cobanov/mini-pc-case/docs/preview.png

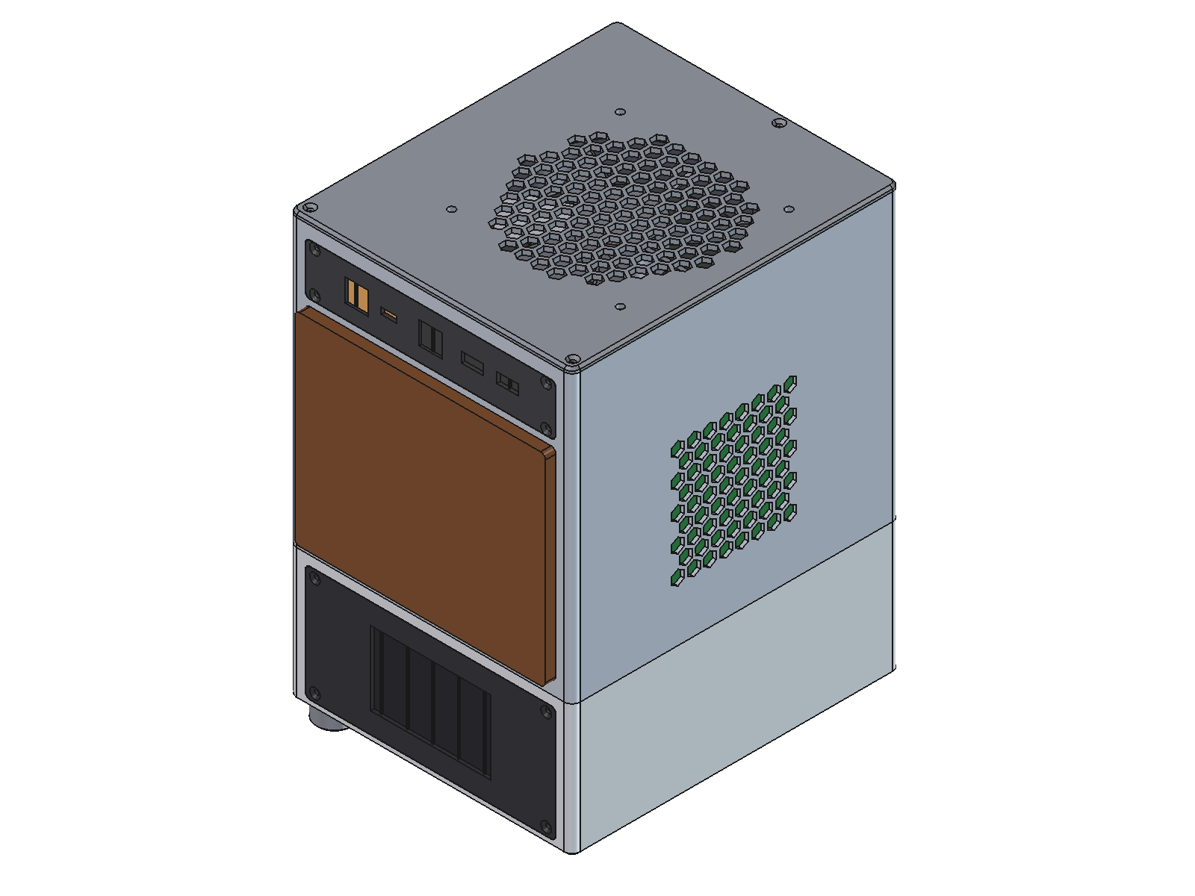
docs/preview.png
