cobanov/mini-pc-case/mini-pc-case.FCStd

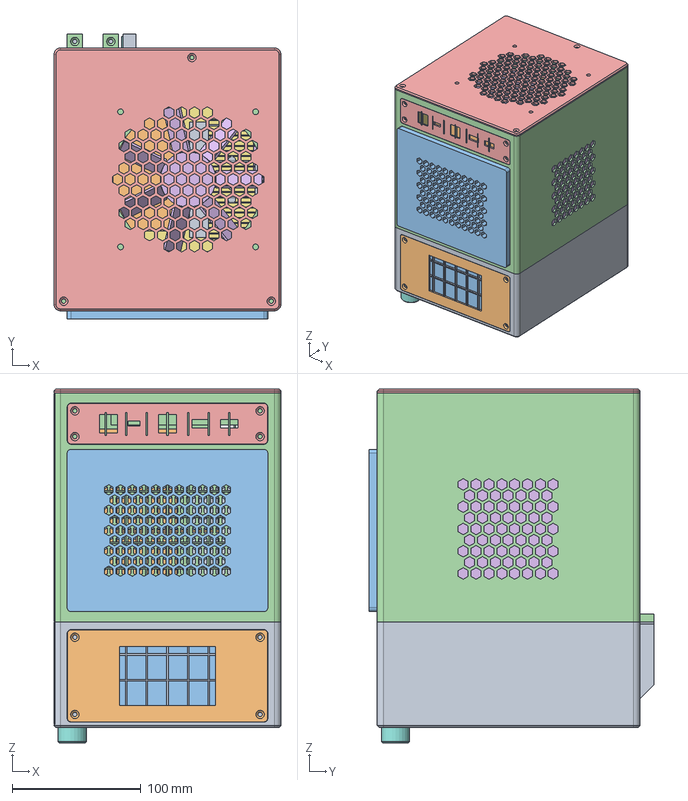
[picture p6: CAD file, 2026-10-29]
mini-pc-case.FCStd
176.4 x 221.9 x 275.2 mm
body_lower
body_upper
body_upper_mesh
body_upper_panel
lid
side_lower
side_upper
foot
psu_support
front_lower
faceplate
front_upper
strip
ref_board
ref_gpu
ref_bracket
ref_cooler
ref_psu
ref_ssd
ref_fan_top
ref_fan_bottom
rotor_top
rotor_bottom
rotor_cpu
rotor_gpu
rotor_psu
ref_lcd
