cobanov/mini-pc-case/stl/body_upper_panel.step

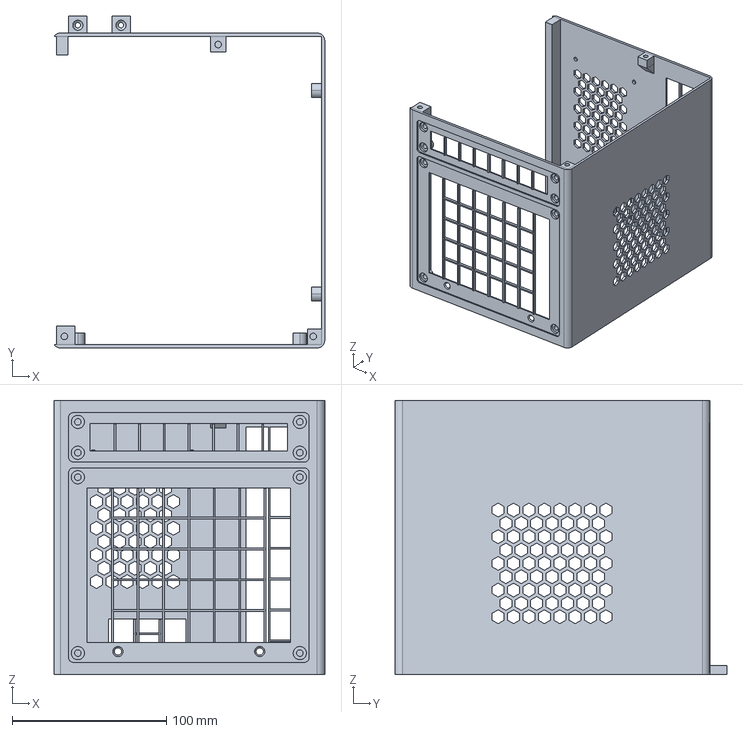
[picture p7: CAD file, 2026-10-29]
stl/body_upper_panel.step
175.5 x 215.4 x 178.0 mm
