cobanov/mini-pc-case/stl/body_upper.step

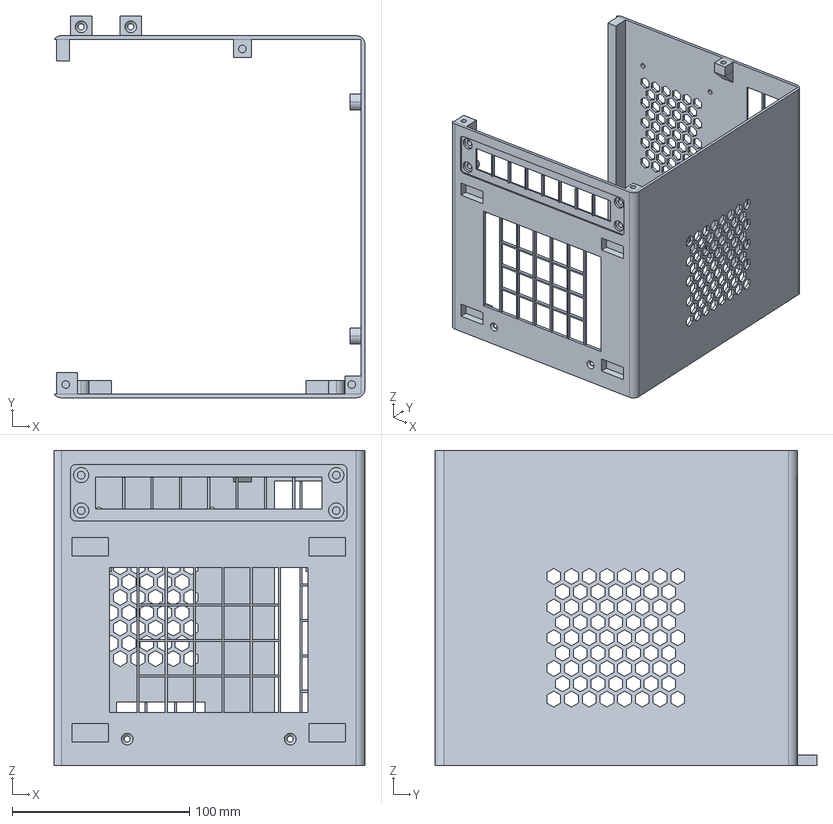
[picture p8: CAD file, 2026-10-29]
stl/body_upper.step
175.5 x 215.4 x 178.0 mm
