cobanov/mini-pc-case/stl/body_lower.step

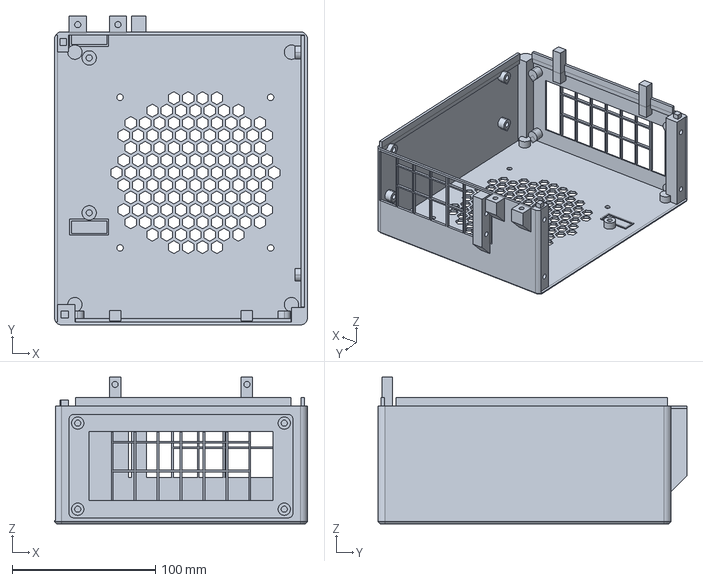
[picture p9: CAD file, 2026-10-29]
stl/body_lower.step
176.4 x 215.4 x 102.2 mm
