cobanov/mini-pc-case/stl/test_piece.step

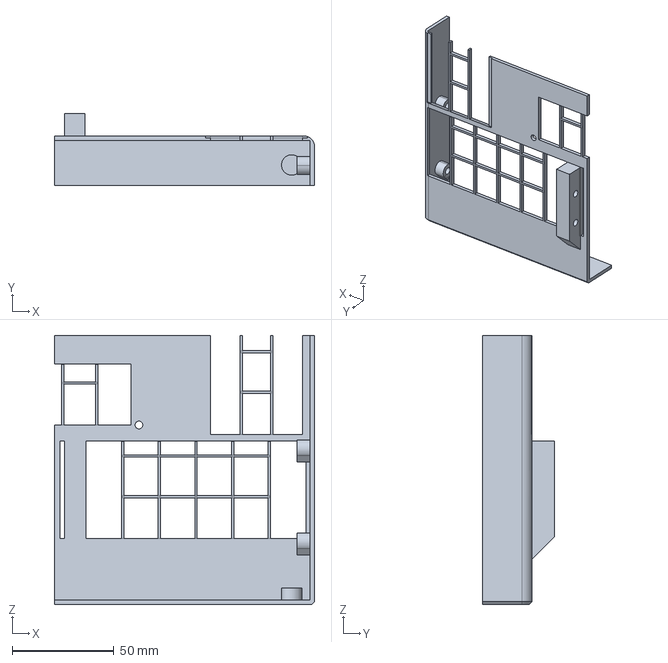
[picture p10: CAD file, 2026-10-28]
stl/test_piece.step
127.6 x 35.2 x 132.2 mm
