cobanov/mini-pc-case/stl/front_upper.step

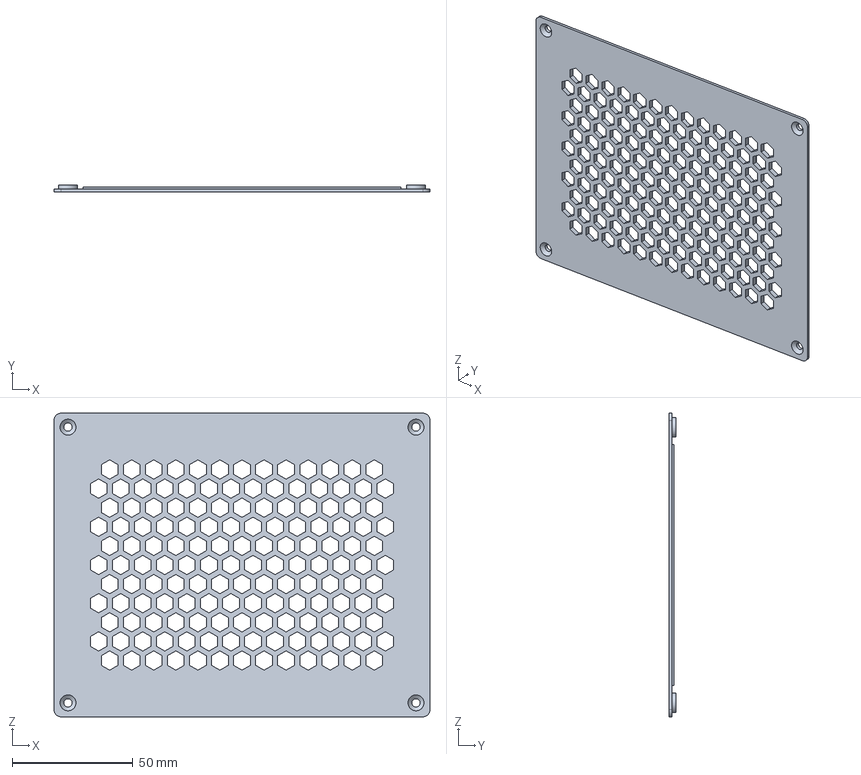
[picture p11: CAD file, 2026-10-24]
stl/front_upper.step
155.6 x 3.04 x 125.7 mm
