cobanov/mini-pc-case/stl/front_upper_fan.step

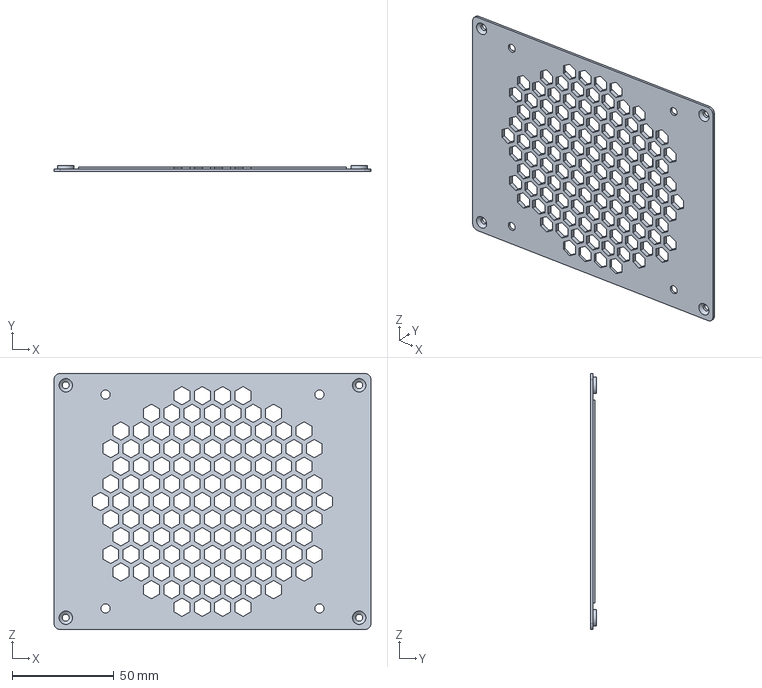
[picture p12: CAD file, 2026-10-24]
stl/front_upper_fan.step
155.6 x 3.04 x 125.7 mm
