cobanov/mini-pc-case/stl/strip_plain.step

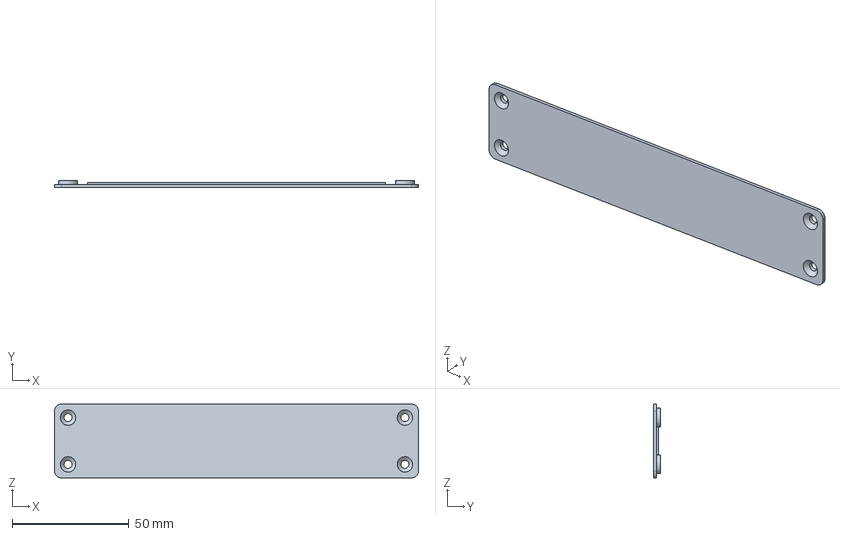
[picture p14: CAD file, 2026-10-24]
stl/strip_plain.step
155.6 x 3.04 x 31.6 mm
