cobanov/mini-pc-case/stl/side_upper.step

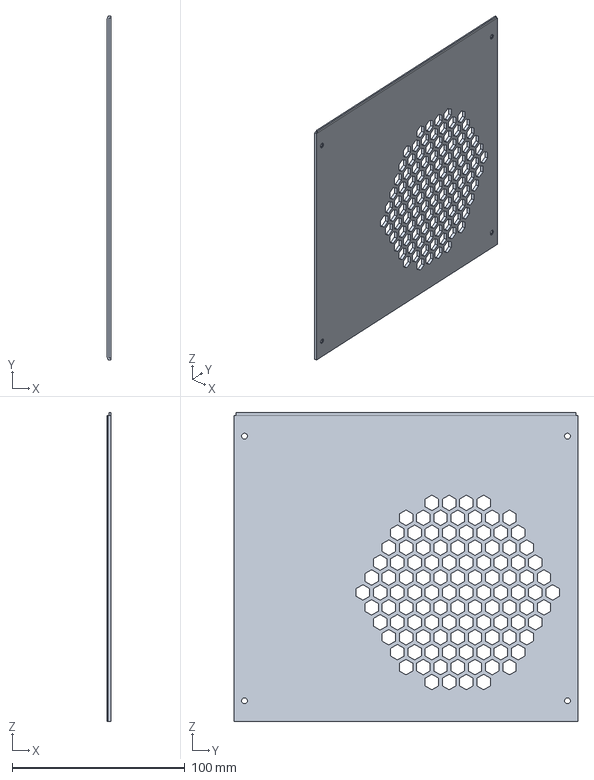
[picture p15: CAD file, 2026-10-24]
stl/side_upper.step
2.20 x 199.2 x 179.1 mm
