cobanov/mini-pc-case/stl/lid.step

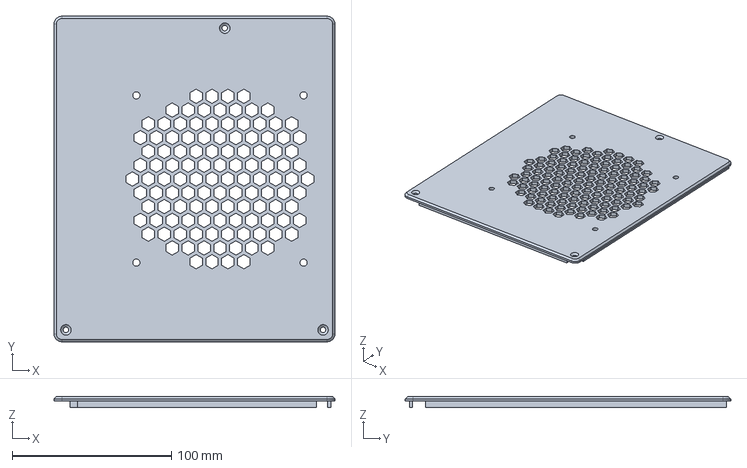
[picture p16: CAD file, 2026-10-24]
stl/lid.step
176.4 x 204.4 x 7.00 mm
