cobanov/mini-pc-case/stl/front_lower_plain.step

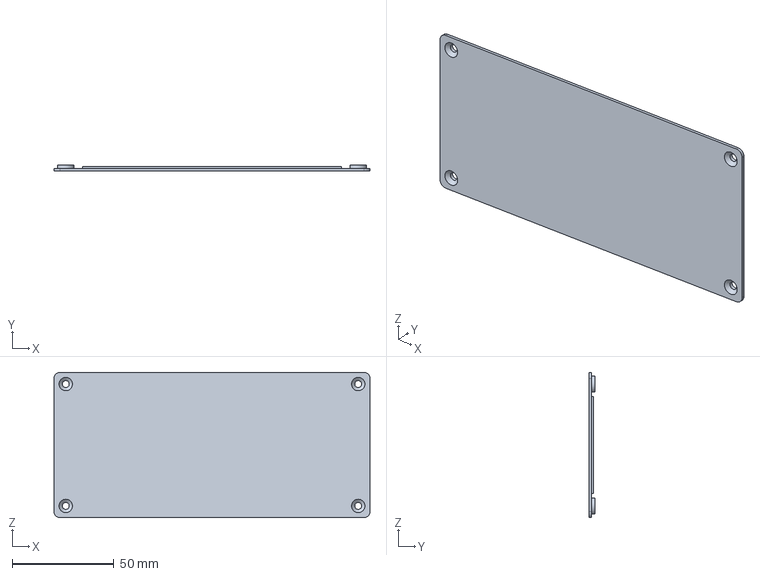
[picture p17: CAD file, 2026-10-24]
stl/front_lower_plain.step
155.6 x 3.04 x 71.6 mm
