cobanov/mini-pc-case/stl/side_lower.step

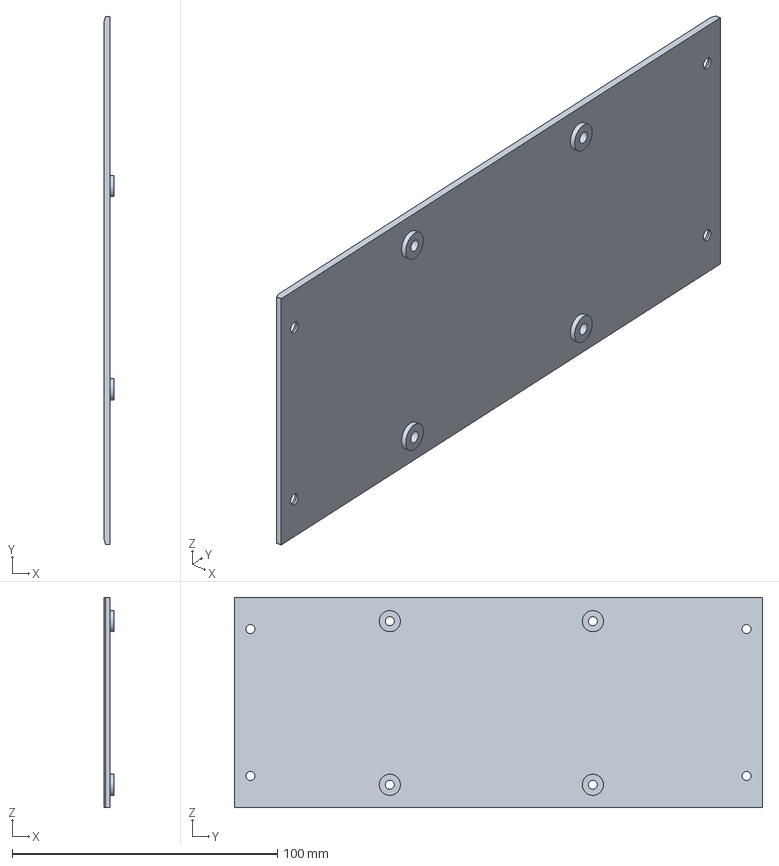
[picture p18: CAD file, 2026-10-24]
stl/side_lower.step
3.70 x 199.2 x 79.4 mm
