cobanov/mini-pc-case/stl/faceplate.step

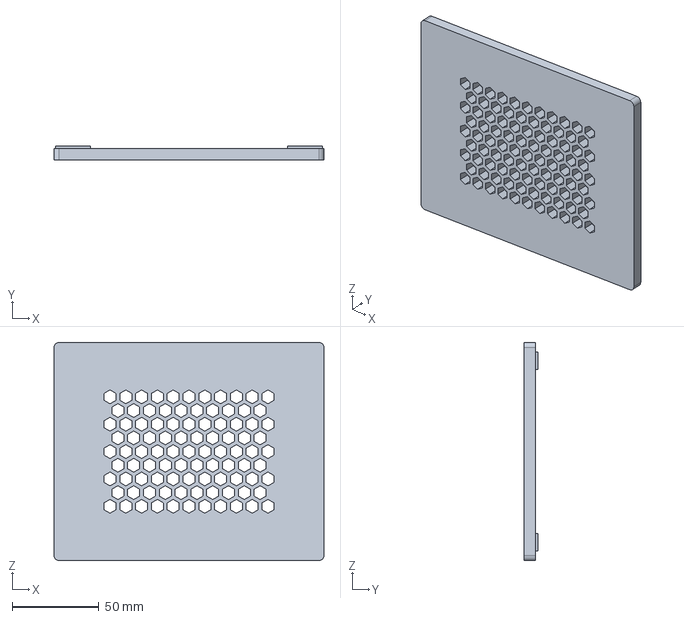
[picture p19: CAD file, 2026-10-24]
stl/faceplate.step
156.0 x 8.00 x 126.1 mm
