cobanov/mini-pc-case/stl/psu_support.step

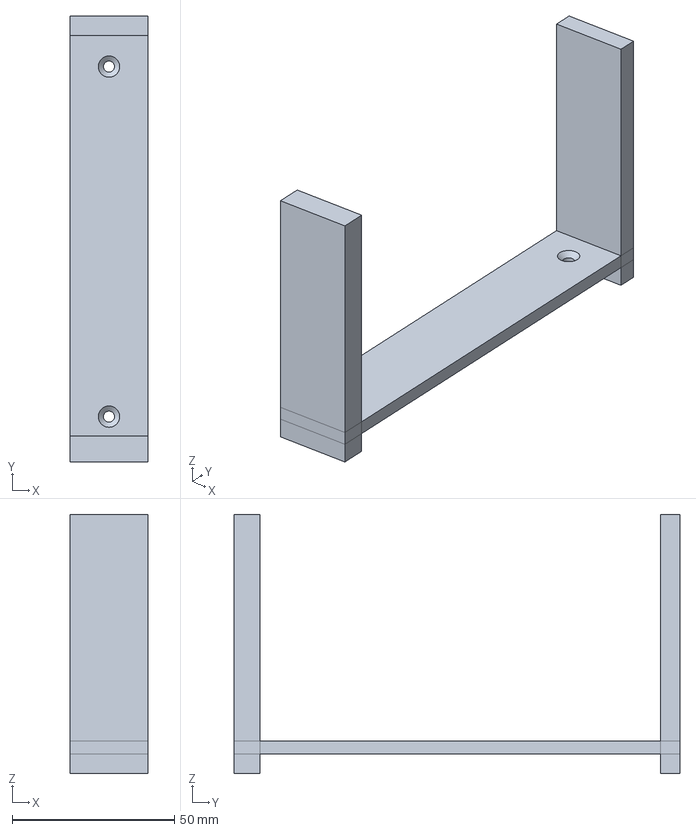
[picture p20: CAD file, 2026-10-24]
stl/psu_support.step
24.0 x 137.6 x 80.0 mm
