cobanov/mini-pc-case/stl/faceplate_plain.step

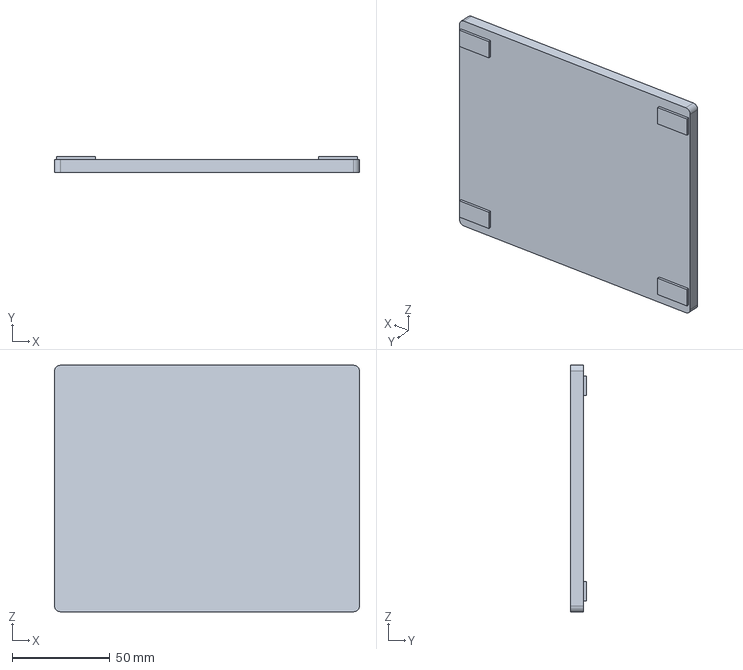
[picture p21: CAD file, 2026-10-24]
stl/faceplate_plain.step
156.0 x 8.00 x 126.1 mm
