cobanov/mini-pc-case/stl/front_upper_screen.step

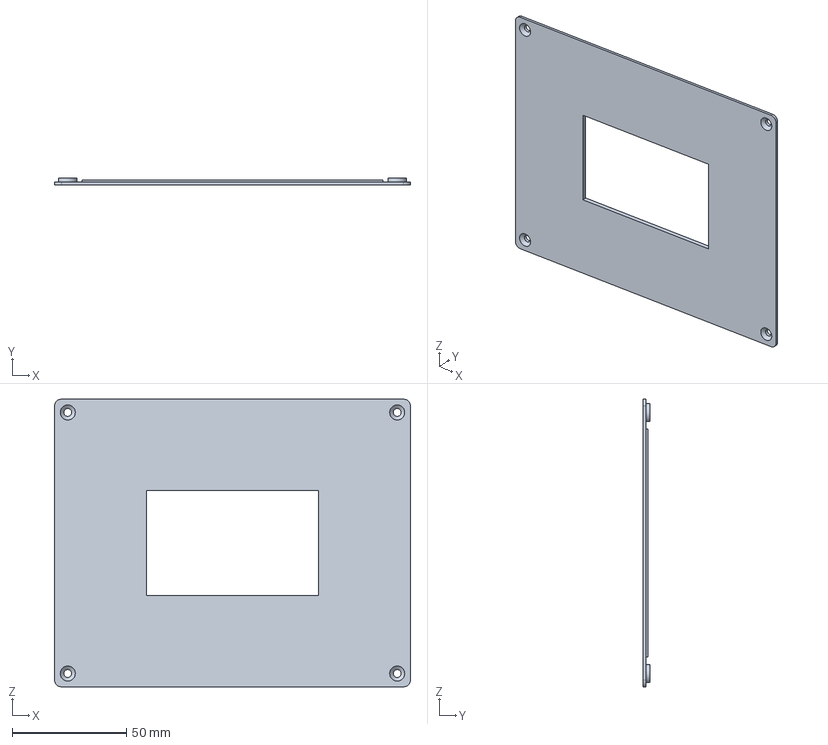
[picture p23: CAD file, 2026-10-24]
stl/front_upper_screen.step
155.6 x 3.04 x 125.7 mm
