cobanov/mini-pc-case/stl/foot.step

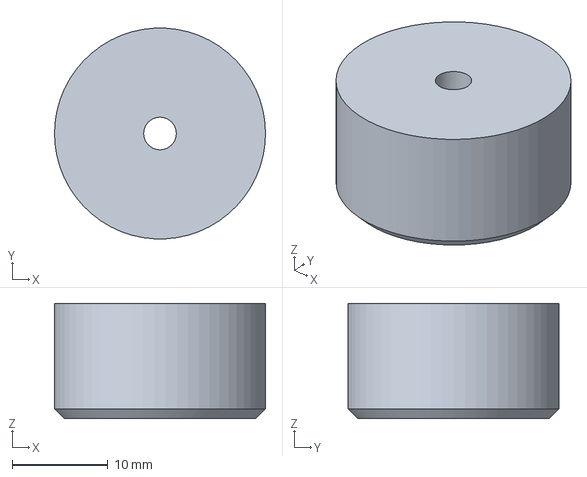
[picture p24: CAD file, 2026-10-24]
stl/foot.step
22.0 x 22.0 x 12.0 mm
