cobanov/mini-pc-case/stl/strip.step

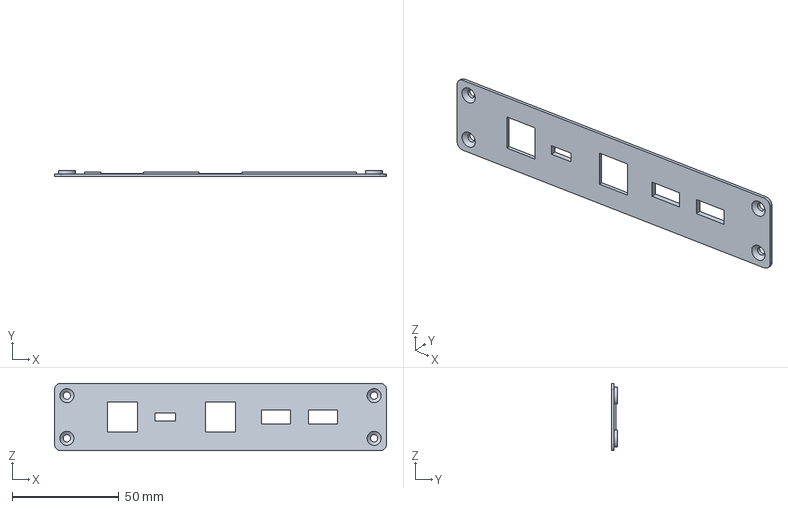
[picture p26: CAD file, 2026-10-24]
stl/strip.step
155.6 x 3.04 x 31.6 mm
