cobanov/mini-pc-case/stl/front_upper_plain.step

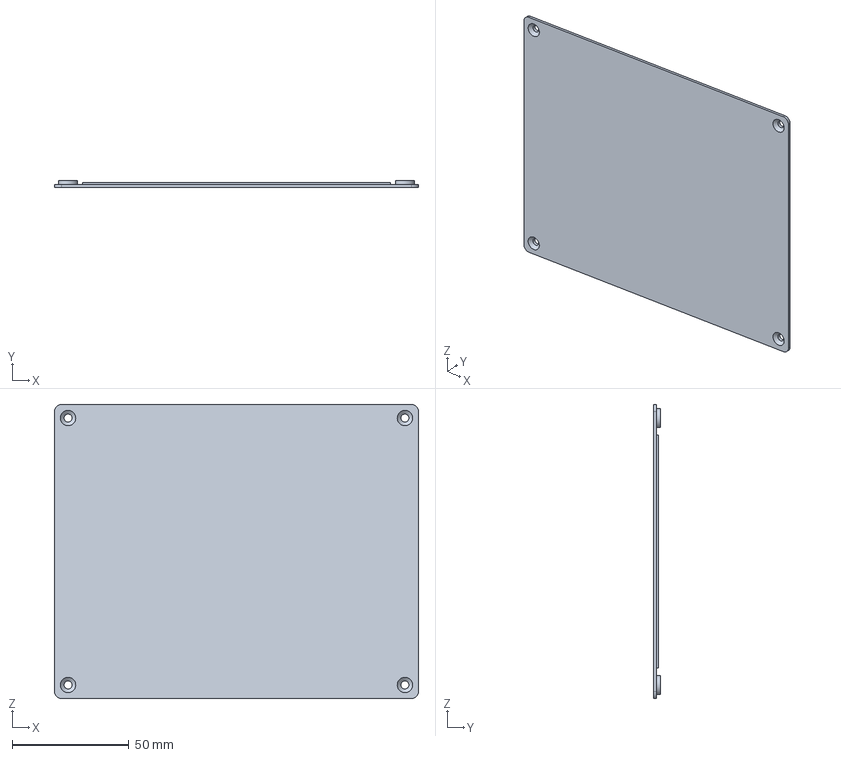
[picture p28: CAD file, 2026-10-24]
stl/front_upper_plain.step
155.6 x 3.04 x 125.7 mm
