cobanov/mini-pc-case/(list of files, cad)

Other CAD files:
stl/body_upper_mesh.step
stl/body_lower.stl
stl/body_upper.stl
stl/body_upper_mesh.stl
stl/body_upper_panel.stl
stl/faceplate.stl
stl/faceplate_plain.stl
stl/faceplate_screen.stl
stl/foot.stl
stl/front_lower.stl
stl/front_lower_mesh.stl
stl/front_lower_plain.stl
stl/front_upper.stl
stl/front_upper_fan.stl
stl/front_upper_plain.stl
stl/front_upper_screen.stl
stl/lid.stl
stl/psu_support.stl
stl/side_lower.stl
stl/side_upper.stl
stl/strip.stl
stl/strip_plain.stl
stl/strip_switches.stl
stl/test_piece.stl
