cobanov/mini-pc-case/(commit log)

2026-10-23 Mini PC case v4: split body, Steam Machine compatible front plate, swappable panels, web viewer
    Claude-Session: https://claude.ai/code/session_01DaiooKNgwSLmkrL9h7BFFJ
    [ayak.step, ayak.stl, deneme_parcasi.step, deneme_parcasi.stl, govde_alt.step, govde_alt.stl, govde_ust.step, govde_ust.stl]
2026-10-23 Add viewer deploy config, preview image
    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
    [mini-pc-kasa.FCStd]
2026-10-24 English names throughout, screw placement standard, removable PSU support, symmetric grilles, size references
    - Removable-part screws: 6 mm from every visible edge (panels, covers, lid, tabs); fastener audit now probes the edge margin around each head
    - Rear joint tabs 12 x 12 at x 14 and 42 (off the GPU opening), lid rear boss and rear post widened
    - PSU support is its own screwed part with a footprint outline on the floor
    - Hex grilles centred and mirror-symmetric
    - Part names, docs (ASSEMBLY.md, NOTES.md, README) and viewer UI in English; parts listed top to bottom
    - Viewer: Steam Machine (Valve CAD) and iPhone 18 Pro Max toggles for scale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
    [ayak.step, body_lower.step, body_lower.stl, body_upper.step, body_upper.stl, deneme_parcasi.step, deneme_parcasi.stl, faceplate.step]
2026-10-24 Faceplate defaults to the mesh variant
    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
    [faceplate_mesh.step, faceplate_mesh.stl, mini-pc-case.FCStd]
2026-10-24 Three upper fronts, 20x10x2 bar magnets, switches-only strip, color groups and palettes
    - body_upper (Steam plate mount), body_upper_mesh (hex mesh, no plate), body_upper_panel (screwed 156x126 panel frame) + front_upper panel variants
    - Magnets: common 20x10x2 mm neodymium bars; plate carries printed bosses, case pocket holds the second bar; front joint screws moved to x 40/132
    - strip_switches: power and reset only
    - Fastener audit covers 43 screws incl. the panel-body joint; print check skips unbuilt variants and now covers the side covers
    - Viewer: parts grouped (body / panels / feet) with group color swatches, 8 palettes, upper-front mode switch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
    [body_lower.step, body_lower.stl, body_upper.step, body_upper.stl, body_upper_mesh.step, body_upper_mesh.stl, body_upper_panel.step, body_upper_panel.stl]
2026-10-28 Breakaway ribs as rung-tied grids spanning the full wall; K1 slicer profiles
    Lone 0.8 mm ribs were knocked over by the nozzle and the thin ones under the
    I/O pocket and panel recesses did not hold. Ribs are now 1.2 mm, run through the
    full wall and are tied together every 20 mm, so each opening's grid snaps out in
    one piece. Adds the OrcaSlicer process and filament profiles used for the K1;
    G-code stays out of the repo.
    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
    [body_lower.step, body_lower.stl, body_upper.step, body_upper.stl, body_upper_mesh.step, body_upper_mesh.stl, body_upper_panel.step, body_upper_panel.stl]
2026-10-28 Blender product renders of the assembled case on an oak desk
    render/render_case.py rebuilds the default assembly from the viewer meshes and
    renders a hero, front, rear and a bone & black palette shot into docs/.
    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
2026-10-29 Teardrop bosses and sloped magnet blocks, welded brims, K1 slicing script with PETG and PLA profiles
    Claude-Session: https://claude.ai/code/session_01PjqH8s4DTP5c2X7LN5jeBP
    [body_lower.step, body_lower.stl, body_upper.step, body_upper.stl, body_upper_mesh.step, body_upper_mesh.stl, body_upper_panel.step, body_upper_panel.stl]
2026-10-29 STL export defaults to ~/Workspace/3d-projects/mini-pc-case/stl
    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
